Bodacious/Polymetis/docs/concept.html

Polymetis · concept sketch

# Polymetis concept

A dark grey 60-key HHKB Professional 2 layout with blank low-profile caps coloured by finger, with modifiers in the body colour. The case outline, key positions and stack come from the design files and Gateron's drawings; the case finish and keycap shape are illustrative.

View: Three-quarter Top Side Low angle

Drag to rotate · scroll or pinch to zoom

## Height stack

Plate, gap, PCB and socket figures are from Gateron's drawings. The frame is 5.3 mm: the 1.3 mm gap, the 1.6 mm PCB and the tallest part underneath (the 2.16 mm flash chip), plus clearance.

## Key figures

Footprint

309.9 × 119.4 mm

Case height

8.1 mm

To cap tops

≈ 17 mm est.

Keys

60, HHKB Pro 2, 6.25u space bar

Switches

Gateron KS-33 Red (linear, 3.0 mm travel) on hot-swap sockets

Stabiliser

Space bar only

USB-C

Back edge, right-hand end

Little finger

Ring

Middle

Index

Thumb

Modifiers (body colour)
