Bodacious/Polymetis/docs/renders/bottom-plate-inside.png

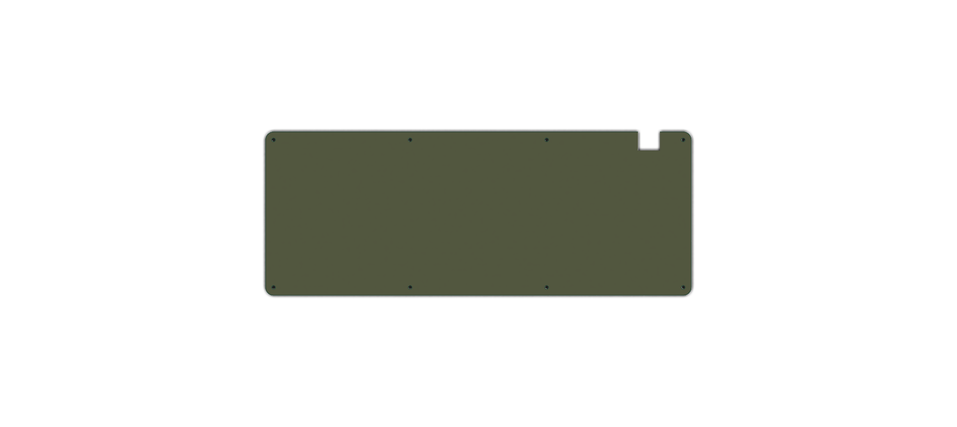
docs/renders/bottom-plate-inside.png
