Bodacious/Polymetis/docs/renders/keyboard-hero.png

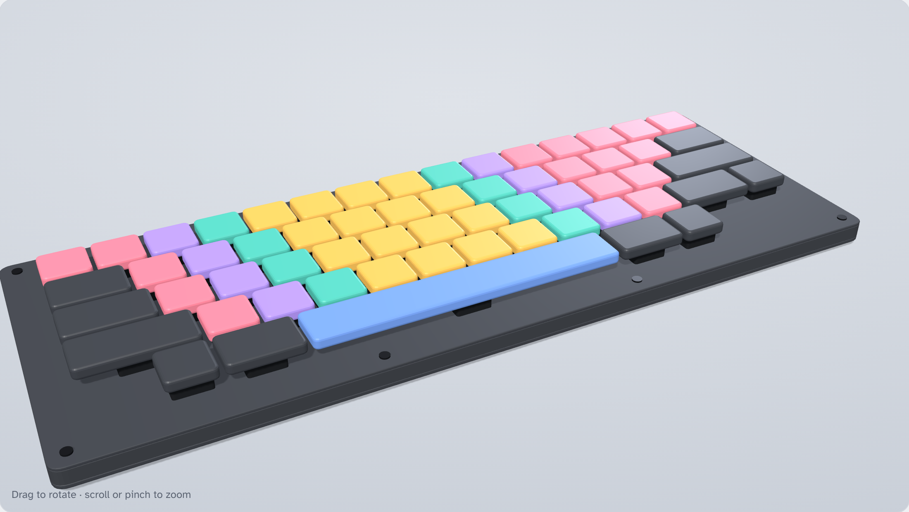
docs/renders/keyboard-hero.png
