Bodacious/Polymetis/docs/renders/keyboard-low.png

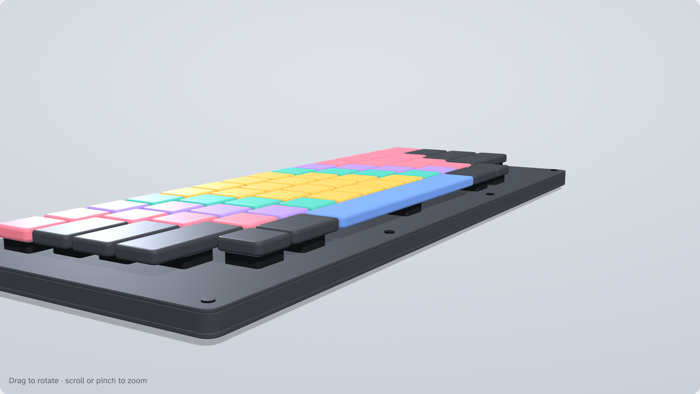
docs/renders/keyboard-low.png
