Bodacious/Polymetis/docs/renders/keyboard-top.png

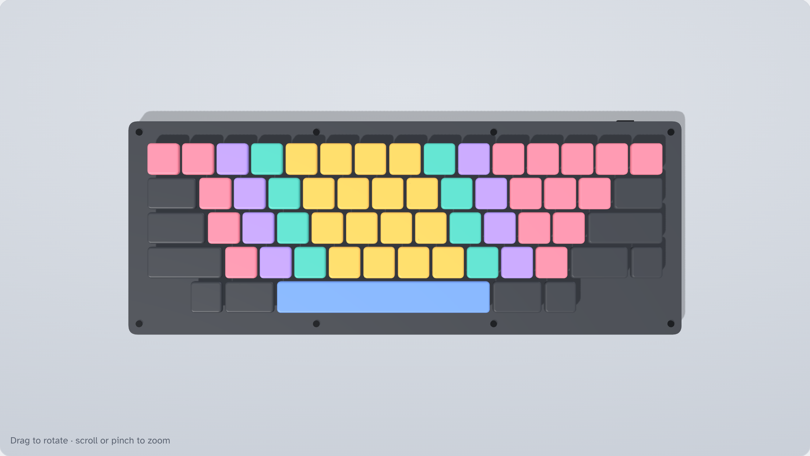
docs/renders/keyboard-top.png
