Bodacious/Polymetis/docs/renders/pcb-component-side.png

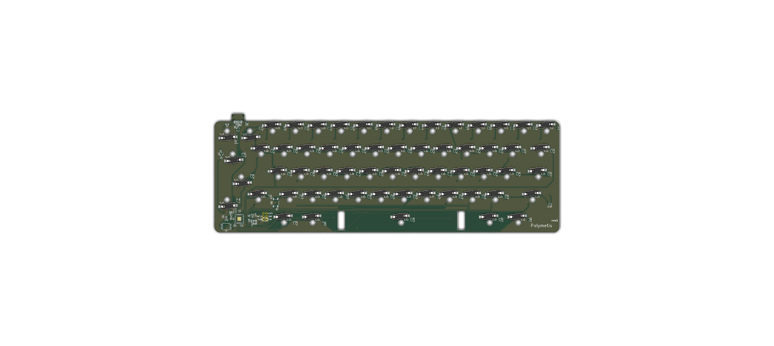
docs/renders/pcb-component-side.png
