Bodacious/Polymetis/case/frame-source.stl

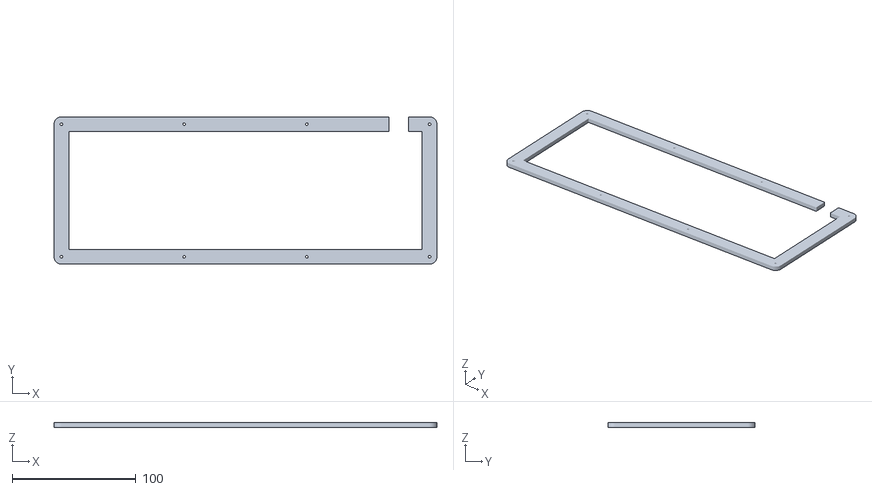
[picture p7: CAD file, 2026-10-15]
case/frame-source.stl
309.8 x 119.2 x 4.00
