Bodacious/Polymetis/pcb/3dmodels/HS_KS-2P02B01-02_KS33.step

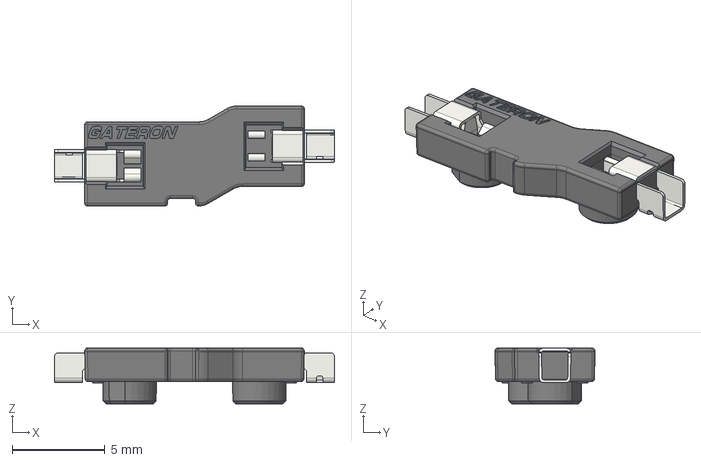
[picture p8: CAD file, 2026-10-14]
pcb/3dmodels/HS_KS-2P02B01-02_KS33.step
15.1 x 5.39 x 3.00 mm
