Bodacious/Polymetis/case/polymetis-frame.stl

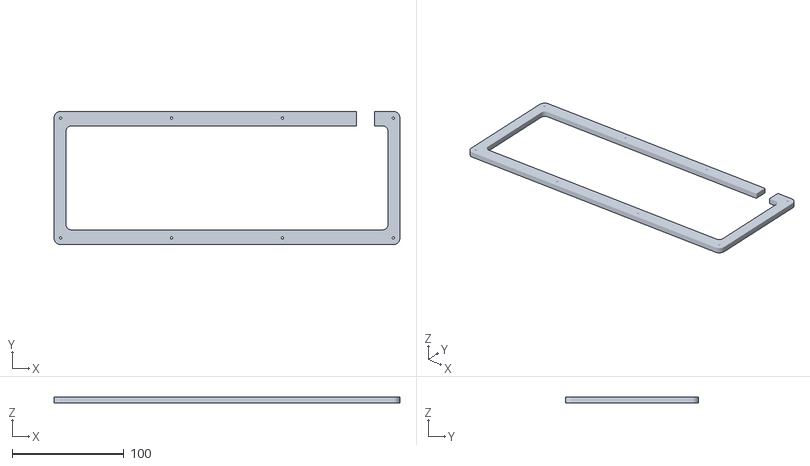
[picture p9: CAD file, 2026-10-14]
case/polymetis-frame.stl
309.8 x 119.2 x 5.30
