Bodacious/Polymetis/pcb/polymetis.kicad_pcb

## KiCad design pcb/polymetis.kicad_pcb (2026-10-15)

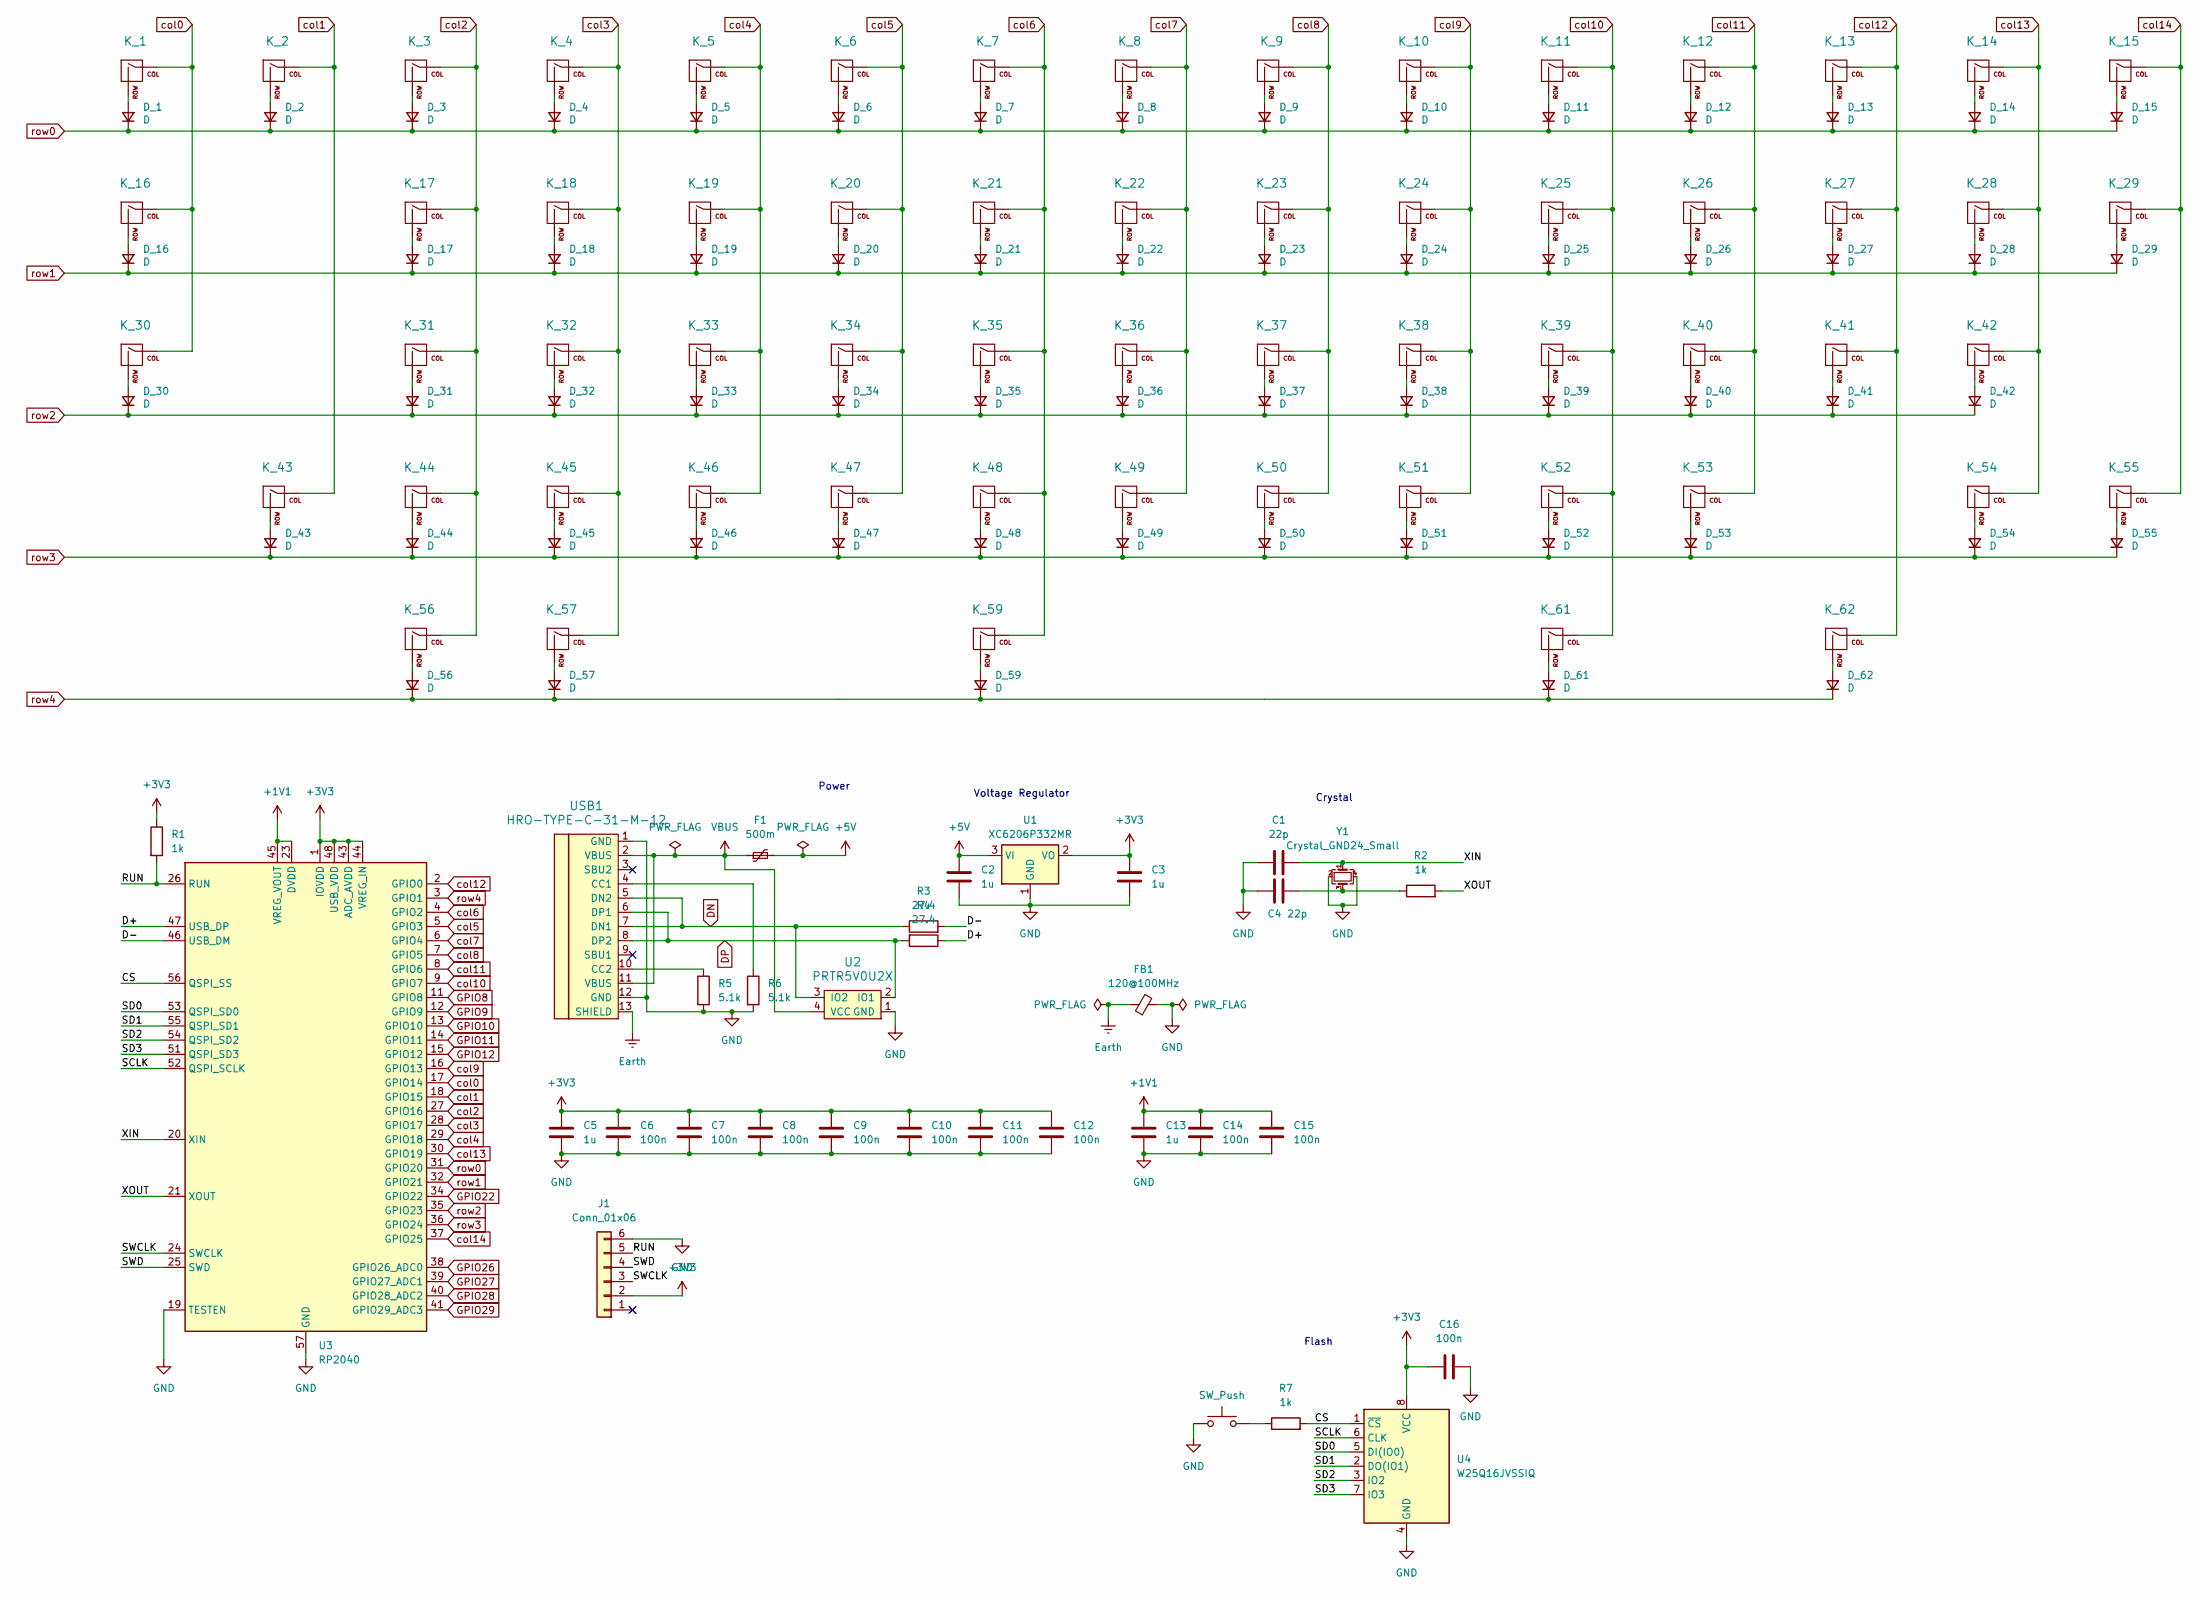
[picture p10: schematic polymetis.kicad_sch]

Parts:
C1, C4: 22p; C_0402_1005Metric; JLCPCB Part C1555
C2, C3, C5, C13: 1u; C_0402_1005Metric; JLCPCB Part C52923
C6, C7, C8, C9, C10, C11, C12, C14, C15, C16: 100n; C_0402_1005Metric; JLCPCB Part C1525
D_1, D_2, D_3, D_4, D_5, D_6, D_7, D_8, D_9, D_10, D_11, D_12, D_13, D_14, D_15, D_16, D_17, D_18, D_19, D_20, D_21, D_22, D_23, D_24, D_25, D_26, D_27, D_28, D_29, D_30, D_31, D_32, D_33, D_34, D_35, D_36, D_37, D_38, D_39, D_40, D_41, D_42, D_43, D_44, D_45, D_46, D_47, D_48, D_49, D_50, D_51, D_52, D_53, D_54, D_55, D_56, D_57, D_59, D_61, D_62: D; D_SOD-323; JLCPCB Part C2128
F1: 500m; Fuse_0805_2012Metric; JLCPCB Part C90129
FB1: 120@100MHz; L_0603_1608Metric; JLCPCB Part C14709
J1: Conn_01x06; Reset_Pretty-Mask_rp2040
K_1: esc; SW_KS33_HS_KS-2P02B01-02_HS_1u
K_2: 1; SW_KS33_HS_KS-2P02B01-02_HS_1u
K_3: 2; SW_KS33_HS_KS-2P02B01-02_HS_1u
K_4: 3; SW_KS33_HS_KS-2P02B01-02_HS_1u
K_5: 4; SW_KS33_HS_KS-2P02B01-02_HS_1u
K_6: 5; SW_KS33_HS_KS-2P02B01-02_HS_1u
K_7: 6; SW_KS33_HS_KS-2P02B01-02_HS_1u
K_8: 7; SW_KS33_HS_KS-2P02B01-02_HS_1u
K_9: 8; SW_KS33_HS_KS-2P02B01-02_HS_1u
K_10: 9; SW_KS33_HS_KS-2P02B01-02_HS_1u
K_11: 0; SW_KS33_HS_KS-2P02B01-02_HS_1u
K_12: minus; SW_KS33_HS_KS-2P02B01-02_HS_1u
K_13: equals; SW_KS33_HS_KS-2P02B01-02_HS_1u
K_14: bash; SW_KS33_HS_KS-2P02B01-02_HS_1u
K_15: grave; SW_KS33_HS_KS-2P02B01-02_HS_1u
K_16: tab; SW_KS33_HS_KS-2P02B01-02_1.5u
K_17: q; SW_KS33_HS_KS-2P02B01-02_HS_1u
K_18: w; SW_KS33_HS_KS-2P02B01-02_HS_1u
K_19: e; SW_KS33_HS_KS-2P02B01-02_HS_1u
K_20: r; SW_KS33_HS_KS-2P02B01-02_HS_1u
K_21: t; SW_KS33_HS_KS-2P02B01-02_HS_1u
K_22: y; SW_KS33_HS_KS-2P02B01-02_HS_1u
K_23: u; SW_KS33_HS_KS-2P02B01-02_HS_1u
K_24: i; SW_KS33_HS_KS-2P02B01-02_HS_1u
K_25: o; SW_KS33_HS_KS-2P02B01-02_HS_1u
K_26: p; SW_KS33_HS_KS-2P02B01-02_HS_1u
K_27: l_brace; SW_KS33_HS_KS-2P02B01-02_HS_1u
K_28: r_brace; SW_KS33_HS_KS-2P02B01-02_HS_1u
K_29: bksp; SW_KS33_HS_KS-2P02B01-02_1.5u
K_30: l_ctrl; SW_KS33_HS_KS-2P02B01-02_1.75u
K_31: a; SW_KS33_HS_KS-2P02B01-02_HS_1u
K_32: s; SW_KS33_HS_KS-2P02B01-02_HS_1u
K_33: d; SW_KS33_HS_KS-2P02B01-02_HS_1u
K_34: f; SW_KS33_HS_KS-2P02B01-02_HS_1u
K_35: g; SW_KS33_HS_KS-2P02B01-02_HS_1u
K_36: h; SW_KS33_HS_KS-2P02B01-02_HS_1u
K_37: j; SW_KS33_HS_KS-2P02B01-02_HS_1u
K_38: k; SW_KS33_HS_KS-2P02B01-02_HS_1u
K_39: l; SW_KS33_HS_KS-2P02B01-02_HS_1u
K_40: semi; SW_KS33_HS_KS-2P02B01-02_HS_1u
K_41: quote; SW_KS33_HS_KS-2P02B01-02_HS_1u
K_42: enter; SW_KS33_HS_KS-2P02B01-02_HS_1u
K_43: l_shift; SW_KS33_HS_KS-2P02B01-02_HS_1u
K_44: z; SW_KS33_HS_KS-2P02B01-02_HS_1u
K_45: x; SW_KS33_HS_KS-2P02B01-02_HS_1u
K_46: c; SW_KS33_HS_KS-2P02B01-02_HS_1u
K_47: v; SW_KS33_HS_KS-2P02B01-02_HS_1u
K_48: b; SW_KS33_HS_KS-2P02B01-02_HS_1u
K_49: n; SW_KS33_HS_KS-2P02B01-02_HS_1u
K_50: m; SW_KS33_HS_KS-2P02B01-02_HS_1u
K_51: comma; SW_KS33_HS_KS-2P02B01-02_HS_1u
K_52: dot; SW_KS33_HS_KS-2P02B01-02_HS_1u
K_53: slash; SW_KS33_HS_KS-2P02B01-02_HS_1u
K_54: r_shift; SW_KS33_HS_KS-2P02B01-02_1.75u
K_55: mo1; SW_KS33_HS_KS-2P02B01-02_HS_1u
K_56: l_gui; SW_KS33_HS_KS-2P02B01-02_HS_1u
K_57: l_alt; SW_KS33_HS_KS-2P02B01-02_1.5u
K_59: mo2; SW_KS33_HS_KS-2P02B01-02_HS_1u
K_61: r_alt; SW_KS33_HS_KS-2P02B01-02_1.5u
K_62: r_ctrl; SW_KS33_HS_KS-2P02B01-02_HS_1u
R1, R2, R7: 1k; R_0402_1005Metric; JLCPCB Part C11702
R3, R4: 27.4; R_0402_1005Metric; JLCPCB Part C274349
R5, R6: 5.1k; R_0402_1005Metric; JLCPCB Part C25905
SW1: SW_Push; SW_SPST_SKQG_WithStem; JLCPCB Part C318884
U1: XC6206P332MR; SOT-23-3; JLCPCB Part C5446
U2: PRTR5V0U2X; SOT-143; JLCPCB Part C2827688
U3: RP2040; QFN-56-1EP_7x7mm_P0.4mm_EP3.2x3.2mm; JLCPCB Part C2040
U4: W25Q16JVSSIQ; SOIC-8_5.23x5.23mm_P1.27mm; JLCPCB Part C131025
USB1: HRO-TYPE-C-31-M-12; HRO-TYPE-C-31-M-12-HandSoldering; JLCPCB Part C165948
Y1: Crystal_GND24_Small; Crystal_SMD_3225-4Pin_3.2x2.5mm; JLCPCB Part C9002

Connections:
+1V1: C13.1, C14.1, C15.1, U3.23 (DVDD), U3.45 (VREG_VOUT), U3.50 (DVDD)
+3V3: C3.1, C5.1, C6.1, C7.1, C8.1, C9.1, C10.1, C11.1, C12.1, C16.1, J1.2, R1.1, U1.2 (VO), U3.1 (IOVDD), U3.10 (IOVDD), U3.22 (IOVDD), U3.33 (IOVDD), U3.42 (IOVDD), U3.43 (ADC_AVDD), U3.44 (VREG_IN), U3.48 (USB_VDD), U3.49 (IOVDD), U4.8 (VCC)
+5V: C2.1, F1.2, U1.3 (VI)
/CS: R7.2, U3.56 (QSPI_SS), U4.1 (~CS)
/D+: R4.1, U3.47 (USB_DP)
/D-: R3.2, U3.46 (USB_DM)
/RUN: J1.5, R1.2, U3.26 (RUN)
/SCLK: U3.52 (QSPI_SCLK), U4.6 (CLK)
/SD0: U3.53 (QSPI_SD0), U4.5 (DI(IO0))
/SD1: U3.55 (QSPI_SD1), U4.2 (DO(IO1))
/SD2: U3.54 (QSPI_SD2), U4.3 (IO2)
/SD3: U3.51 (QSPI_SD3), U4.7 (IO3)
/SWCLK: J1.3, U3.24 (SWCLK)
/SWD: J1.4, U3.25 (SWD)
/XIN: C1.2, U3.20 (XIN), Y1.1
/XOUT: R2.2, U3.21 (XOUT)
DN: R3.1, U2.3 (IO2), USB1.5 (DN2), USB1.7 (DN1)
DP: R4.2, U2.2 (IO1), USB1.6 (DP1), USB1.8 (DP2)
Earth: FB1.1, USB1.13 (SHIELD)
GND: C1.1, C2.2, C3.2, C4.1, C5.2, C6.2, C7.2, C8.2, C9.2, C10.2, C11.2, C12.2, C13.2, C14.2, C15.2, C16.2, FB1.2, J1.6, R5.2, R6.2, SW1.1, U1.1 (GND), U2.1 (GND), U3.19 (TESTEN), U3.57 (GND), U4.4 (GND), USB1.1 (GND), USB1.12 (GND), Y1.2, Y1.4
GPIO8: U3.11 (GPIO8)
GPIO9: U3.12 (GPIO9)
GPIO10: U3.13 (GPIO10)
GPIO11: U3.14 (GPIO11)
GPIO12: U3.15 (GPIO12)
GPIO22: U3.34 (GPIO22)
GPIO26: U3.38 (GPIO26_ADC0)
GPIO27: U3.39 (GPIO27_ADC1)
GPIO28: U3.40 (GPIO28_ADC2)
GPIO29: U3.41 (GPIO29_ADC3)
unnamed: C4.2, R2.1, Y1.3
unnamed: D_1.2 (A), K_1.2 (ROW)
unnamed: D_2.2 (A), K_2.2 (ROW)
unnamed: D_3.2 (A), K_3.2 (ROW)
unnamed: D_4.2 (A), K_4.2 (ROW)
unnamed: D_5.2 (A), K_5.2 (ROW)
unnamed: D_6.2 (A), K_6.2 (ROW)
unnamed: D_7.2 (A), K_7.2 (ROW)
unnamed: D_8.2 (A), K_8.2 (ROW)
unnamed: D_9.2 (A), K_9.2 (ROW)
unnamed: D_10.2 (A), K_10.2 (ROW)
unnamed: D_11.2 (A), K_11.2 (ROW)
unnamed: D_12.2 (A), K_12.2 (ROW)
unnamed: D_13.2 (A), K_13.2 (ROW)
unnamed: D_14.2 (A), K_14.2 (ROW)
unnamed: D_15.2 (A), K_15.2 (ROW)
unnamed: D_16.2 (A), K_16.2 (ROW)
unnamed: D_17.2 (A), K_17.2 (ROW)
unnamed: D_18.2 (A), K_18.2 (ROW)
unnamed: D_19.2 (A), K_19.2 (ROW)
unnamed: D_20.2 (A), K_20.2 (ROW)
unnamed: D_21.2 (A), K_21.2 (ROW)
unnamed: D_22.2 (A), K_22.2 (ROW)
unnamed: D_23.2 (A), K_23.2 (ROW)
unnamed: D_24.2 (A), K_24.2 (ROW)
unnamed: D_25.2 (A), K_25.2 (ROW)
unnamed: D_26.2 (A), K_26.2 (ROW)
unnamed: D_27.2 (A), K_27.2 (ROW)
unnamed: D_28.2 (A), K_28.2 (ROW)
unnamed: D_29.2 (A), K_29.2 (ROW)
unnamed: D_30.2 (A), K_30.2 (ROW)
unnamed: D_31.2 (A), K_31.2 (ROW)
unnamed: D_32.2 (A), K_32.2 (ROW)
unnamed: D_33.2 (A), K_33.2 (ROW)
unnamed: D_34.2 (A), K_34.2 (ROW)
unnamed: D_35.2 (A), K_35.2 (ROW)
unnamed: D_36.2 (A), K_36.2 (ROW)
unnamed: D_37.2 (A), K_37.2 (ROW)
unnamed: D_38.2 (A), K_38.2 (ROW)
unnamed: D_39.2 (A), K_39.2 (ROW)
unnamed: D_40.2 (A), K_40.2 (ROW)
unnamed: D_41.2 (A), K_41.2 (ROW)
unnamed: D_42.2 (A), K_42.2 (ROW)
unnamed: D_43.2 (A), K_43.2 (ROW)
unnamed: D_44.2 (A), K_44.2 (ROW)
unnamed: D_45.2 (A), K_45.2 (ROW)
unnamed: D_46.2 (A), K_46.2 (ROW)
unnamed: D_47.2 (A), K_47.2 (ROW)
unnamed: D_48.2 (A), K_48.2 (ROW)
unnamed: D_49.2 (A), K_49.2 (ROW)
unnamed: D_50.2 (A), K_50.2 (ROW)
unnamed: D_51.2 (A), K_51.2 (ROW)
unnamed: D_52.2 (A), K_52.2 (ROW)
unnamed: D_53.2 (A), K_53.2 (ROW)
unnamed: D_54.2 (A), K_54.2 (ROW)
unnamed: D_55.2 (A), K_55.2 (ROW)
unnamed: D_56.2 (A), K_56.2 (ROW)
unnamed: D_57.2 (A), K_57.2 (ROW)
unnamed: D_59.2 (A), K_59.2 (ROW)
unnamed: D_61.2 (A), K_61.2 (ROW)
unnamed: D_62.2 (A), K_62.2 (ROW)
unnamed: R7.1, SW1.2
unnamed: R6.1, USB1.4 (CC1)
unnamed: R5.1, USB1.10 (CC2)
VBUS: F1.1, U2.4 (VCC), USB1.2 (VBUS), USB1.11 (VBUS)
col0: K_1.1 (COL), K_16.1 (COL), K_30.1 (COL), U3.17 (GPIO14)
col1: K_2.1 (COL), K_43.1 (COL), U3.18 (GPIO15)
col2: K_3.1 (COL), K_17.1 (COL), K_31.1 (COL), K_44.1 (COL), K_56.1 (COL), U3.27 (GPIO16)
col3: K_4.1 (COL), K_18.1 (COL), K_32.1 (COL), K_45.1 (COL), K_57.1 (COL), U3.28 (GPIO17)
col4: K_5.1 (COL), K_19.1 (COL), K_33.1 (COL), K_46.1 (COL), U3.29 (GPIO18)
col5: K_6.1 (COL), K_20.1 (COL), K_34.1 (COL), K_47.1 (COL), U3.5 (GPIO3)
col6: K_7.1 (COL), K_21.1 (COL), K_35.1 (COL), K_48.1 (COL), K_59.1 (COL), U3.4 (GPIO2)
col7: K_8.1 (COL), K_22.1 (COL), K_36.1 (COL), K_49.1 (COL), U3.6 (GPIO4)
col8: K_9.1 (COL), K_23.1 (COL), K_37.1 (COL), K_50.1 (COL), U3.7 (GPIO5)
col9: K_10.1 (COL), K_24.1 (COL), K_38.1 (COL), K_51.1 (COL), U3.16 (GPIO13)
col10: K_11.1 (COL), K_25.1 (COL), K_39.1 (COL), K_52.1 (COL), K_61.1 (COL), U3.9 (GPIO7)
col11: K_12.1 (COL), K_26.1 (COL), K_40.1 (COL), K_53.1 (COL), U3.8 (GPIO6)
col12: K_13.1 (COL), K_27.1 (COL), K_41.1 (COL), K_62.1 (COL), U3.2 (GPIO0)
col13: K_14.1 (COL), K_28.1 (COL), K_42.1 (COL), K_54.1 (COL), U3.30 (GPIO19)
col14: K_15.1 (COL), K_29.1 (COL), K_55.1 (COL), U3.37 (GPIO25)
row0: D_1.1 (K), D_2.1 (K), D_3.1 (K), D_4.1 (K), D_5.1 (K), D_6.1 (K), D_7.1 (K), D_8.1 (K), D_9.1 (K), D_10.1 (K), D_11.1 (K), D_12.1 (K), D_13.1 (K), D_14.1 (K), D_15.1 (K), U3.31 (GPIO20)
row1: D_16.1 (K), D_17.1 (K), D_18.1 (K), D_19.1 (K), D_20.1 (K), D_21.1 (K), D_22.1 (K), D_23.1 (K), D_24.1 (K), D_25.1 (K), D_26.1 (K), D_27.1 (K), D_28.1 (K), D_29.1 (K), U3.32 (GPIO21)
row2: D_30.1 (K), D_31.1 (K), D_32.1 (K), D_33.1 (K), D_34.1 (K), D_35.1 (K), D_36.1 (K), D_37.1 (K), D_38.1 (K), D_39.1 (K), D_40.1 (K), D_41.1 (K), D_42.1 (K), U3.35 (GPIO23)
row3: D_43.1 (K), D_44.1 (K), D_45.1 (K), D_46.1 (K), D_47.1 (K), D_48.1 (K), D_49.1 (K), D_50.1 (K), D_51.1 (K), D_52.1 (K), D_53.1 (K), D_54.1 (K), D_55.1 (K), U3.36 (GPIO24)
row4: D_56.1 (K), D_57.1 (K), D_59.1 (K), D_61.1 (K), D_62.1 (K), U3.3 (GPIO1)

Notes on the sheet:
Flash
Power
Crystal
Voltage Regulator

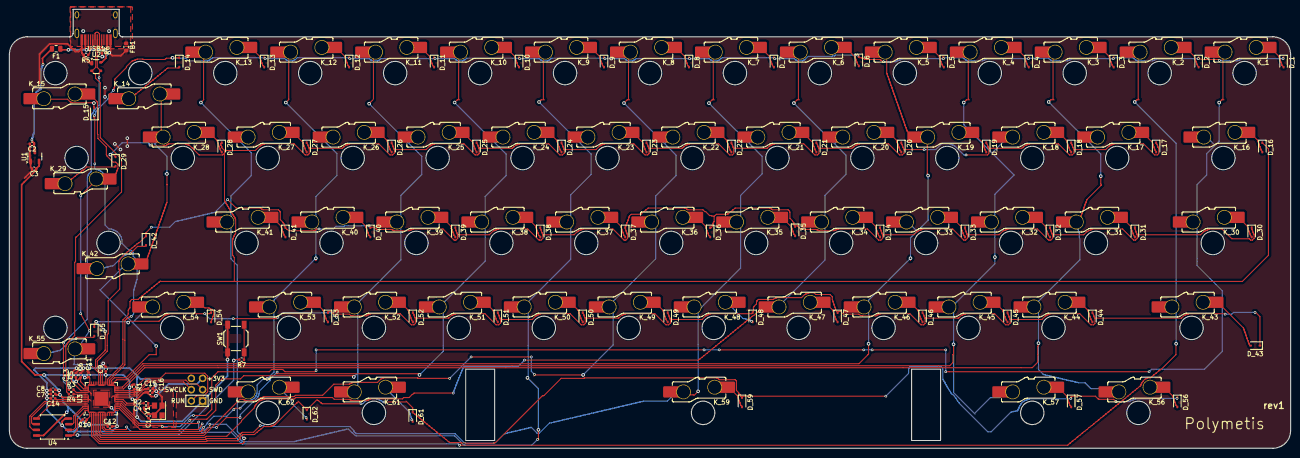
[picture p11: board polymetis.kicad_pcb from above]

Board: 2 copper layers, 287.3 x 98.4 mm, 154 parts (0 on the bottom side), 105 nets.

Other parts of the board:
ST1: KS-57B623T; STAB_Gateron_LP_6.25U_PCB
