Bodacious/Polymetis/(commit log)

2026-10-12 Add handover brief for the Gateron KS-33 HHKB Pro 2 rework
    HANDOVER.md records the design decisions, measured facts about the
    existing board, plate and frame files, exact coordinates for the new
    one-piece spacebar row, and a step-by-step plan for Claude Code to carry
    out in KiCad on a machine where it can be installed. CLAUDE.md points
    Claude Code at it and sets the ground rules.
    Claude-Session: https://claude.ai/code/session_01KALBKFfkmqYWZG2zn8x5fm
2026-10-12 Upgrade KiCad boards to KiCad 9 file format
    No design changes: boards loaded and re-saved with pcbnew 9.0.9 so the
    following commits show only real edits. Schematic left in KiCad 8 format
    (kicad-cli 9 has no schematic upgrade; KiCad 9 opens it as is).
    Claude-Session: https://claude.ai/code/session_011sJxCFL16sEAYrBmNTBwJC
    [boethia60.kicad_pcb, bottom-plate.kicad_pcb, top-plate.kicad_pcb]
2026-10-12 Firmware and layout: HHKB Pro 2 bottom row, drop layer 2
    Bottom row is now 1.25u blank, Alt, Cmd 1.5u, Space 6.25u, Cmd 1.5u,
    Alt, 2.5u blank. The one-piece spacebar keeps matrix position (4,6),
    so no wiring change; (4,5) and (4,8) are gone with the split spacebar.
    The MO(2) key no longer exists, so layer 2 (arrows on H J K L) is
    removed and layers = 2. Layer 1 (HHKB Fn layer) is unchanged.
    vial.json and boethia60.json now describe 60 keys. Firmware builds with
    cargo build --release on RMK 0.5.1.
    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
2026-10-14 Add to-scale layout drawing with per-finger key colours
    docs/layout.html draws the 60-key HHKB Pro 2 layout at 1u = 19.05 mm,
    colours each key by finger (little, ring, middle, index, thumb), counts
    keycaps per colour and size, and marks the space bar centre against the
    case centre.
    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
2026-10-14 Add Gateron datasheets for KS-33, socket and stabilisers
    Primary sources for the switch, hot-swap socket and low-profile
    plate-mounted stabilisers, with a README recording what each drawing
    confirms.
    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
2026-10-14 Layout page: modifiers take their finger's colour (five colours)
    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
2026-10-14 Add 3D concept model of the keyboard
    docs/concept.html renders a rotatable three.js model: dark grey case at
    the real plate outline, 60 blank caps in the five finger colours, M2
    screw heads at the plate hole positions, USB-C on the back edge, and a
    to-scale cross-section of the stack from Gateron's figures.
    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
2026-10-14 Vendor marbastlib KS-33 hot-swap footprints into the project
    Copies SW_KS33_HS_KS-2P02B01-02 (1u, 1.25u, 1.5u, 1.75u) and the
    socket STEP model from ebastler/marbastlib 6b0a9a7 (CERN-OHL-P-2.0,
    licence included) so the project opens without the plugin manager.
    Model paths point at ${KIPRJMOD}/3dmodels. Footprint pin and pad
    geometry checked against Gateron's KS-33 and KS-2P02B01-02 drawings
    (docs/datasheets).
    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
    [HS_KS-2P02B01-02_KS33.step]
2026-10-14 Schematic: KS-33 hot-swap footprints, remove split-spacebar switches
    All 60 switch symbols now use the marbastlib KS-33 / KS-2P02B01-02
    hot-swap footprints (1.5u and 1.75u variants for Tab, Backspace, Cmd,
    Ctrl and right Shift; 1u elsewhere, including the 2.25u and 6.25u keys).
    K_58, D_58, K_60 and D_60 and their wires are deleted; the space bar
    keeps K_59 at matrix position (4,6). ERC reports nothing new; the
    remaining items are pre-existing in the RP2040 section.
    Also adds the board-only footprint for the Gateron 6.25U stabiliser
    PCB slots (6.5 x 16 mm at 100 mm spacing, after Keebio's slot).
    Claude-Session: https://claude.ai/code/s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
    [boethia60.kicad_sch]
2026-10-14 Top plate: KS-33 cut-outs, Gateron 6.25U stabiliser cut-out, 1.2 mm
    Switch cut-outs are 14.00 mm squares (Gateron KS-33 drawing) at the
    new switch positions, including the HHKB Pro 2 bottom row. The space
    bar cut-out is merged with Gateron's recommended KS-57B623T stabiliser
    cut-out at 100 mm stem spacing, notch facing the back to match the PCB
    slots. Board thickness set to 1.2 mm (KS-33 and stabiliser drawings).
    Outline and M2 holes unchanged. DRC: 0 violations.
    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
    [top-plate.kicad_pcb]
2026-10-14 Frame 5.0 mm for the KS-33 stack; bottom plate USB notch
    case/make_frame.py rebuilds the printed middle frame from the original
    shell and M2 holes, with the cavity cut from the real PCB outline plus
    0.3 mm (the original cavity was 1.6 mm narrower than the PCB) and a
    5.0 mm thickness: 1.30 plate-to-PCB gap + 1.60 PCB + 1.87 socket
    + 0.23 clearance, from Gateron's KS-33 and KS-2P02B01-02 drawings.
    The 16 mm USB opening is kept. Output: case/polymetis-frame.stl.
    The USB-C receptacle hangs 3.26 mm below the PCB (HRO TYPE-C-31-M-12
    drawing), so the bottom plate gets a 16 x 13.7 mm notch under the
    frame's USB opening, as the original README suggested. The plate is
    drawn from below (logo outward);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
    [bottom-plate.kicad_pcb, polymetis-frame.stl]
2026-10-14 Frame: 5.3 mm to clear the SOIC-8 flash chip
    The flash (W25Q16JVSSIQ, 208-mil SOIC-8) is up to 2.16 mm tall per
    Winbond's datasheet, taller than the 1.87 mm hot-swap sockets, so it
    sets the space under the PCB: 1.30 + 1.60 + 2.16 + 0.24 = 5.30 mm.
    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
    [polymetis-frame.stl]
2026-10-15 PCB (work in progress): KS-33 footprints, HHKB bottom row, matrix rerouted
    Not finished: 4 matrix connections still open (col0, col10, col14, row3);
    DRC otherwise reports only the two pre-existing USB1 pad clearances plus
    two to review. Factory files are not regenerated yet.
    - 60 KS-33 hot-swap footprints, sockets on the underside; 55 rotated 180
    degrees so the diode pad faces the diode (K_14, K_15, K_29, K_42, K_55
    stay at 0 next to the USB connector)
    - K_58/D_58/K_60/D_60 removed; bottom row moved per HANDOVER.md section 5
    - Gateron 6.25U stabiliser slots (ST1), wire-hook side to the back
    - original row/column routing kept where it does not clash; the rest
    routed by a grid router; d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
    [boethia60.kicad_pcb]
2026-10-15 PCB: finish matrix routing
    Close the last four links by hand (row 3, col 0, col 10, col 14). Col 0
    leaves its old y 76.5 mm lane, which crosses both stabiliser slots, and
    runs under the row 3 switches instead; col 9 drops one lane beside the
    RP2040 to make room for a col 0 via. Remove dead-end vias and stubs left
    from the original routing. DRC: 0 unconnected pads; only the two
    pre-existing USB1 pad clearances remain.
    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
    [boethia60.kicad_pcb]
2026-10-15 Regenerate factory files, checks and renders; update README
    Gerbers, drill files, CPL and BOM for the main PCB (60 diodes, sockets
    hand-soldered), Gerbers for both plates, ERC/DRC reports in docs/checks,
    renders in docs/renders, and tools/export.sh to rebuild them all.
    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
    [boethia60-B_Cu.gbr, boethia60-B_Mask.gbr, boethia60-B_Paste.gbr, boethia60-B_Silkscreen.gbr, boethia60-Edge_Cuts.gbr, boethia60-F_Cu.gbr, boethia60-F_Mask.gbr, boethia60-F_Paste.gbr]
2026-10-15 Fn layer: F1-F12, media on I O P and A S D F; refresh project docs
    Fn layer gains F1-F12 on the number row, Insert/Delete on \ and `,
    previous/next/play-pause on I O P and volume down/up, mute, eject on
    A S D F. HANDOVER.md becomes a current decisions-and-status page (aims,
    one stabiliser, Red KS-33 for short travel, finger colours including
    modifiers, work on main); the original brief moves to docs/history.
    CLAUDE.md states the aims; README documents the Fn layer and UF2
    flashing.
    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
2026-10-15 Fn layer: replicate the HHKB Professional 2 Fn layer
    Every HHKB Pro 2 Fn combination, per QMK's HHKB keymap: Power on Esc,
    F1-F12, Insert/Delete, Caps Lock on Tab, Print Screen/Scroll Lock/Pause
    on I O P, volume and mute on A S D, keypad * / + - and Enter, and the
    arrow/Home/End/PgUp/PgDn cluster. Eject stays on F (the HHKB's Mac-mode
    key). Track controls move to Z X C and the bootloader to B, keys the
    HHKB leaves unused.
    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
2026-10-15 BOM: flash U4 to C131025 (same W25Q16JVSSIQ, in stock)
    C82317 has 8 left at JLCPCB; C131025 is the same Winbond part in the
    same SOIC-8 208-mil package with 1,317 in stock.
    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
    [boethia60.kicad_sch, boethia60_bom.csv]
2026-10-15 Fuse, part labels, Polymetis name
    - F1: the original BOM fitted a ferrite bead (C1015) where the schematic
    has a 500 mA fuse; now SMD0805P050TF/12 (C90129, 500 mA hold, 1 A
    trip, 12 V) on the same 0805 footprint, which carries its terminals.
    - Labels match the fitted parts: U1 XC6206P332MR, U4 W25Q16JVSSIQ,
    FB1 120@100MHz (BLM18PG121SN1D), with datasheet links.
    - Board text: Polymetis, based on boethia60 by arviceblot, moved clear
    of D_56 and rev1, in KiCad's stroke font.
    - USB product name, Vial and KLE layout names: Polymetis.
    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
    [boethia60-B_Cu.gbr, boethia60-B_Mask.gbr, boethia60-B_Paste.gbr, boethia60-B_Silkscreen.gbr, boethia60-Edge_Cuts.gbr, boethia60-F_Cu.gbr, boethia60-F_Mask.gbr, boethia60-F_Paste.gbr]
2026-10-15 Concept model: final specs; add 3D renders of the assembled keyboard
    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
2026-10-15 Drop references to the original design; dark grey modifier keycaps
    - Main PCB project moves to pcb/polymetis.*; firmware crate, KLE layout,
    factory files, check reports and UF2 are named polymetis.
    - Board text: the credit line is removed. Bottom plate: the old logo is
    replaced by Polymetis text on the outside face.
    - Unused legacy files removed: KiCad 5 project, kbplacer log, FreeCAD
    frame, plate-generator outlines, the original handover brief. The
    frame script reads case/frame-source.stl.
    - README, HANDOVER and CLAUDE.md no longer describe Polymetis as a fork.
    LICENSE is unchanged: the MIT terms require its copyright and
    permission notice to stay with the design.
    - Keycaps: a s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
    [0cebd8e7179c38d7ca830ee3c2892adf3e2daf86_bottom.dxf, 0cebd8e7179c38d7ca830ee3c2892adf3e2daf86_open.dxf, 0cebd8e7179c38d7ca830ee3c2892adf3e2daf86_switch.dxf, 0cebd8e7179c38d7ca830ee3c2892adf3e2daf86_top.dxf, HS_KS-2P02B01-02_KS33.step, Middle.FCStd, boethia60.sch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]
2026-10-16 Pre-order verification: plates, frame, USB opening, firmware matrix
    tools/verify/run.sh cross-checks the top plate against the main PCB,
    the plates and frame against each other, the USB opening and bottom-
    plate notch against the receptacle, and the firmware pin map and keymap
    against the board's copper. All pass; results in
    docs/checks/pre-order-verification.md. The USB-C plug sits low, so the
    parts list gains rubber feet.
    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
